74hc595/7400-Drum-Machine/drummachine.pdf

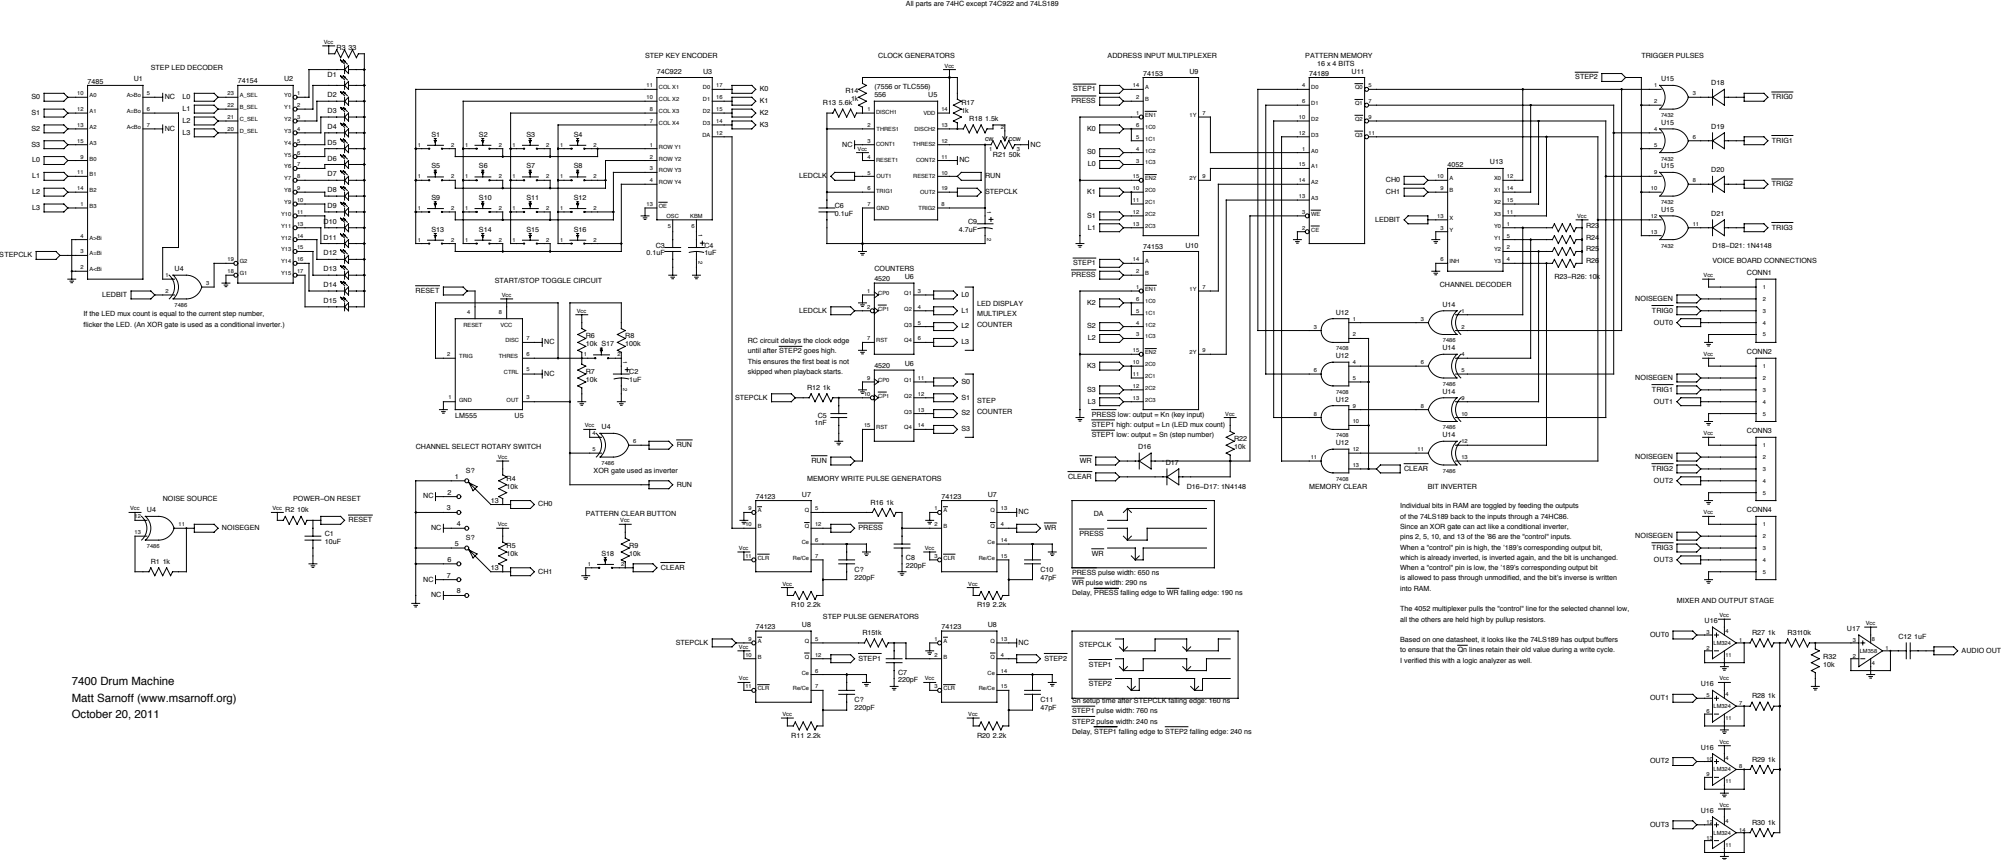
[picture p1: page 1]

All parts are 74HC except 74C922 and 74LS189

START/STOP TOGGLE CIRCUIT

If the LED mux count is equal to the current step number,
flicker the LED. (An XOR gate is used as a conditional inverter.)

RC circuit delays the clock edge
until after STEP2 goes high.
This ensures the first beat is not
skipped when playback starts.

PRESS low: output = Kn (key input)
STEP1 high: output = Ln (LED mux count)
STEP1 low: output = Sn (step number)

CHANNEL SELECT ROTARY SWITCH

XOR gate used as inverter

MEMORY WRITE PULSE GENERATORS

Individual bits in RAM are toggled by feeding the outputs
of the 74LS189 back to the inputs through a 74HC86.
Since an XOR gate can act like a conditional inverter,
pins 2, 5, 10, and 13 of the ’86 are the "control" inputs.

When a "control" pin is high, the ’189’s corresponding output bit,
which is already inverted, is inverted again, and the bit is unchanged.
When a "control" pin is low, the ’189’s corresponding output bit
is allowed to pass through unmodified, and the bit’s inverse is written
into RAM.

WR pulse width: 290 ns
Delay, PRESS falling edge to WR falling edge: 190 ns

MIXER AND OUTPUT STAGE

The 4052 multiplexer pulls the "control" line for the selected channel low,
all the others are held high by pullup resistors.

Based on one datasheet, it looks like the 74LS189 has output buffers
to ensure that the Qn lines retain their old value during a write cycle.
I verified this with a logic analyzer as well.

7400 Drum Machine
Matt Sarnoff (www.msarnoff.org)
October 20, 2011

Sn setup time after STEPCLK falling edge: 160 ns
STEP1 pulse width: 760 ns
STEP2 pulse width: 240 ns
Delay, STEP1 falling edge to STEP2 falling edge: 240 ns
