74hc595/7400-Drum-Machine/voiceboard.pdf

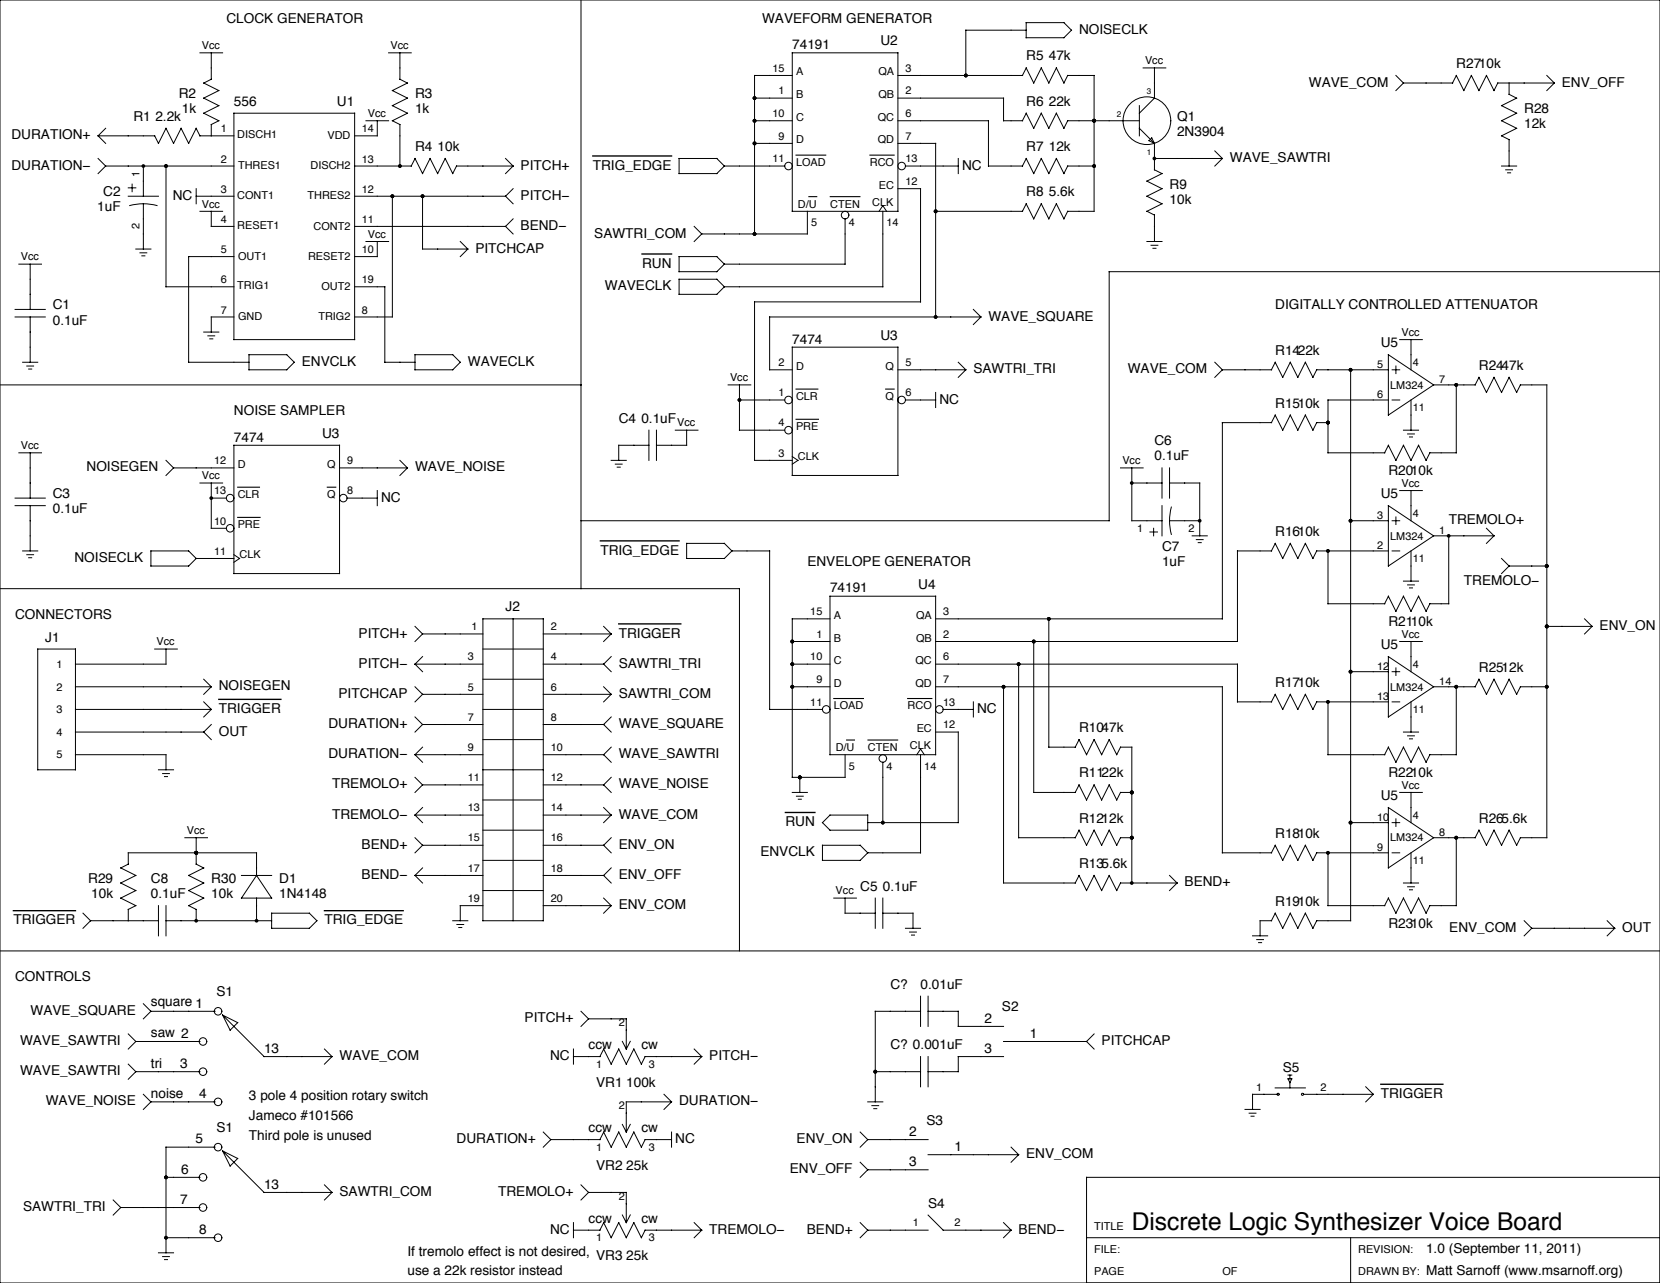
[picture p2: page 1]

3 pole 4 position rotary switch
Jameco #101566
Third pole is unused

Discrete Logic Synthesizer Voice Board

1.0 (September 11, 2011)
Matt Sarnoff (www.msarnoff.org)

If tremolo effect is not desired,
use a 22k resistor instead
