74hc595/7400-Drum-Machine/(commit log)

2011-10-21 adding gEDA schematics
    [drummachine.sch, voiceboard.sch]
2011-10-21 added some missing refdes labels
    [drummachine.sch]
